matteoborghi/pecd-p7-kicad/PECD_P7.kicad_pcb

## KiCad design PECD_P7.kicad_pcb (2026-10-15)

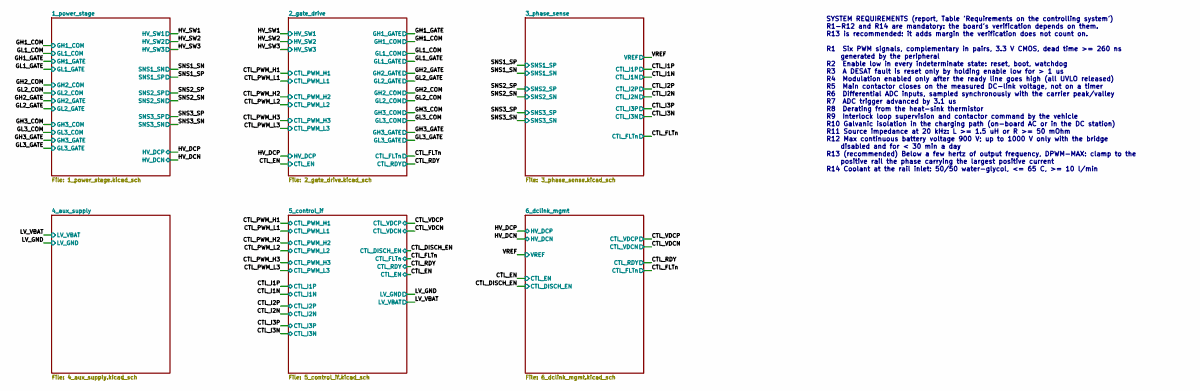
[picture p1: schematic PECD_P7.kicad_sch, Root sheet: blocks, interface and system requirements]

Notes on the sheet:
SYSTEM REQUIREMENTS (report, Table 'Requirements on the controlling system') R1-R12 and R14 are mandatory: the board's verification depends on them. R13 is recommended: it adds margin the verification does not count on. R1 Six PWM signals, complementary in pairs, 3.3 V CMOS, dead time >= 260 ns gen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

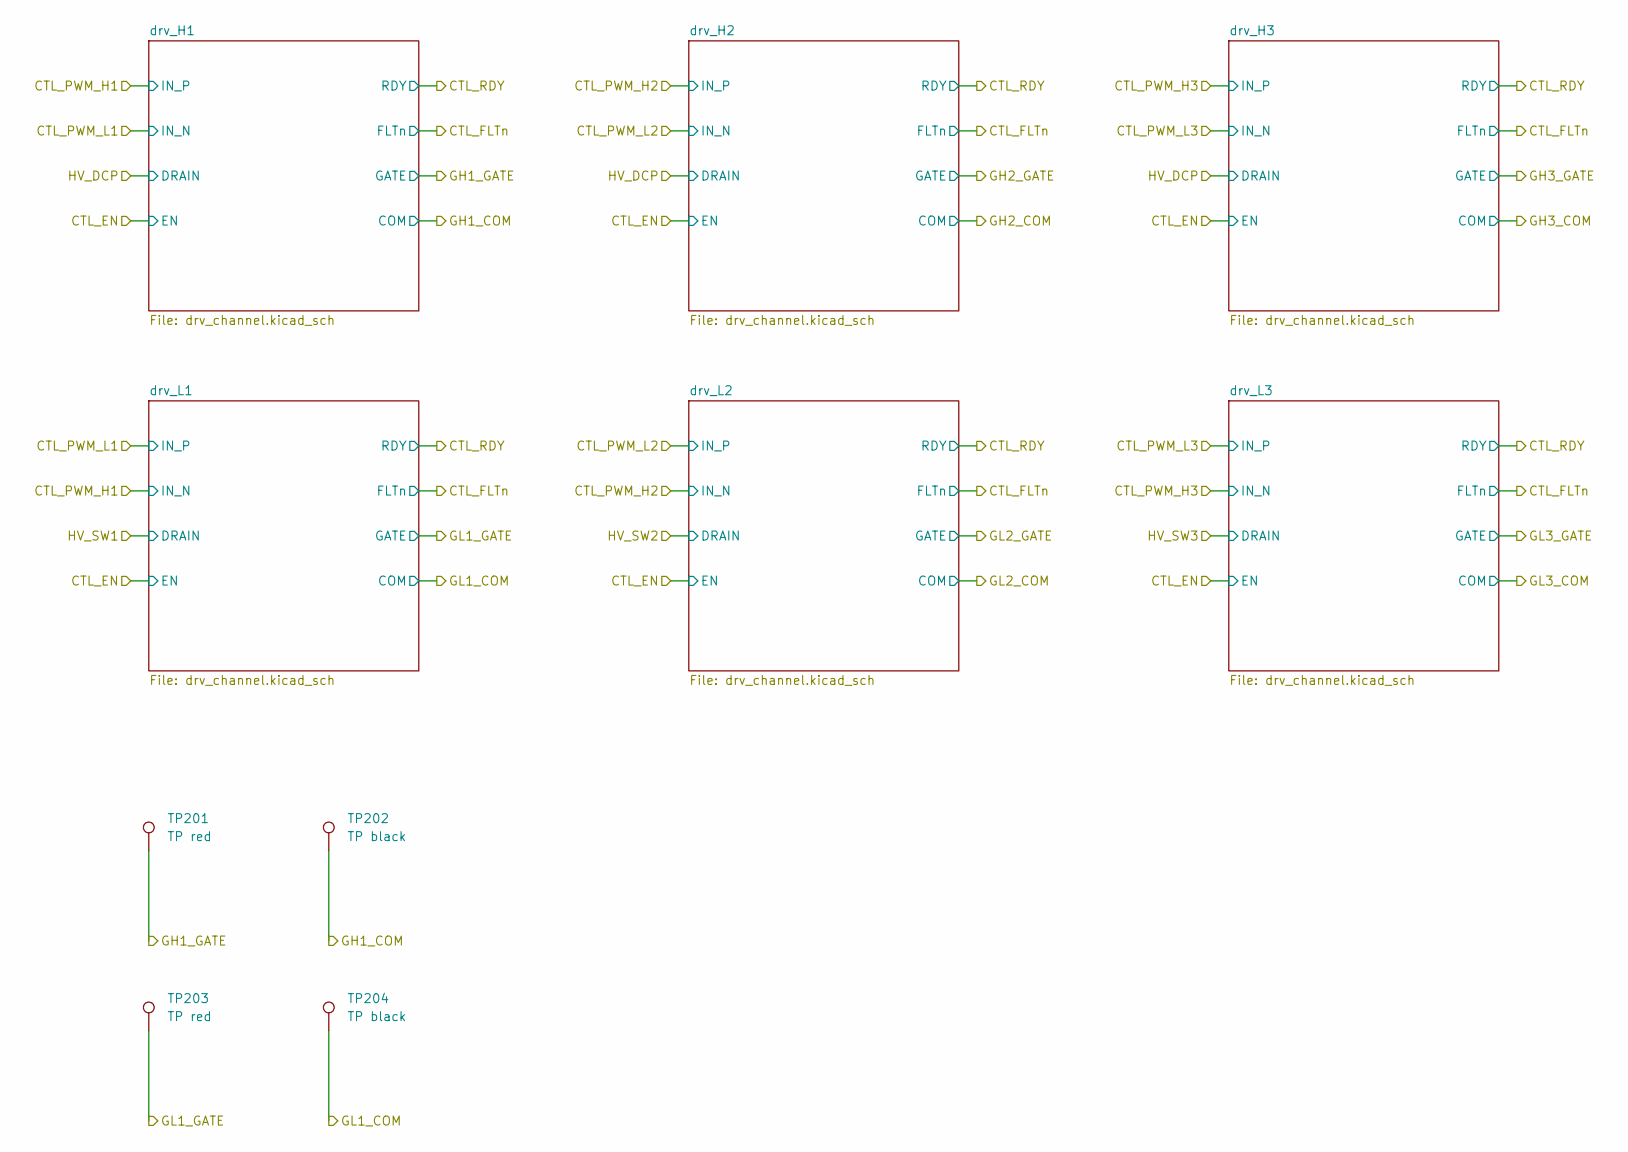
[picture p2: schematic 2_gate_drive.kicad_sch, Gate drive: seven channels and interlock]

Parts:
TP201, TP203: TP red; TestPoint_Keystone_5000-5004_Miniature; MPN 5000
TP202, TP204: TP black; TestPoint_Keystone_5000-5004_Miniature; MPN 5001

Connections:
/GH1_COM: TP202.1 (1_1); also elsewhere on the board
/GH1_GATE: TP201.1 (1_1); also elsewhere on the board
/GL1_COM: TP204.1 (1_1); also elsewhere on the board
/GL1_GATE: TP203.1 (1_1); also elsewhere on the board

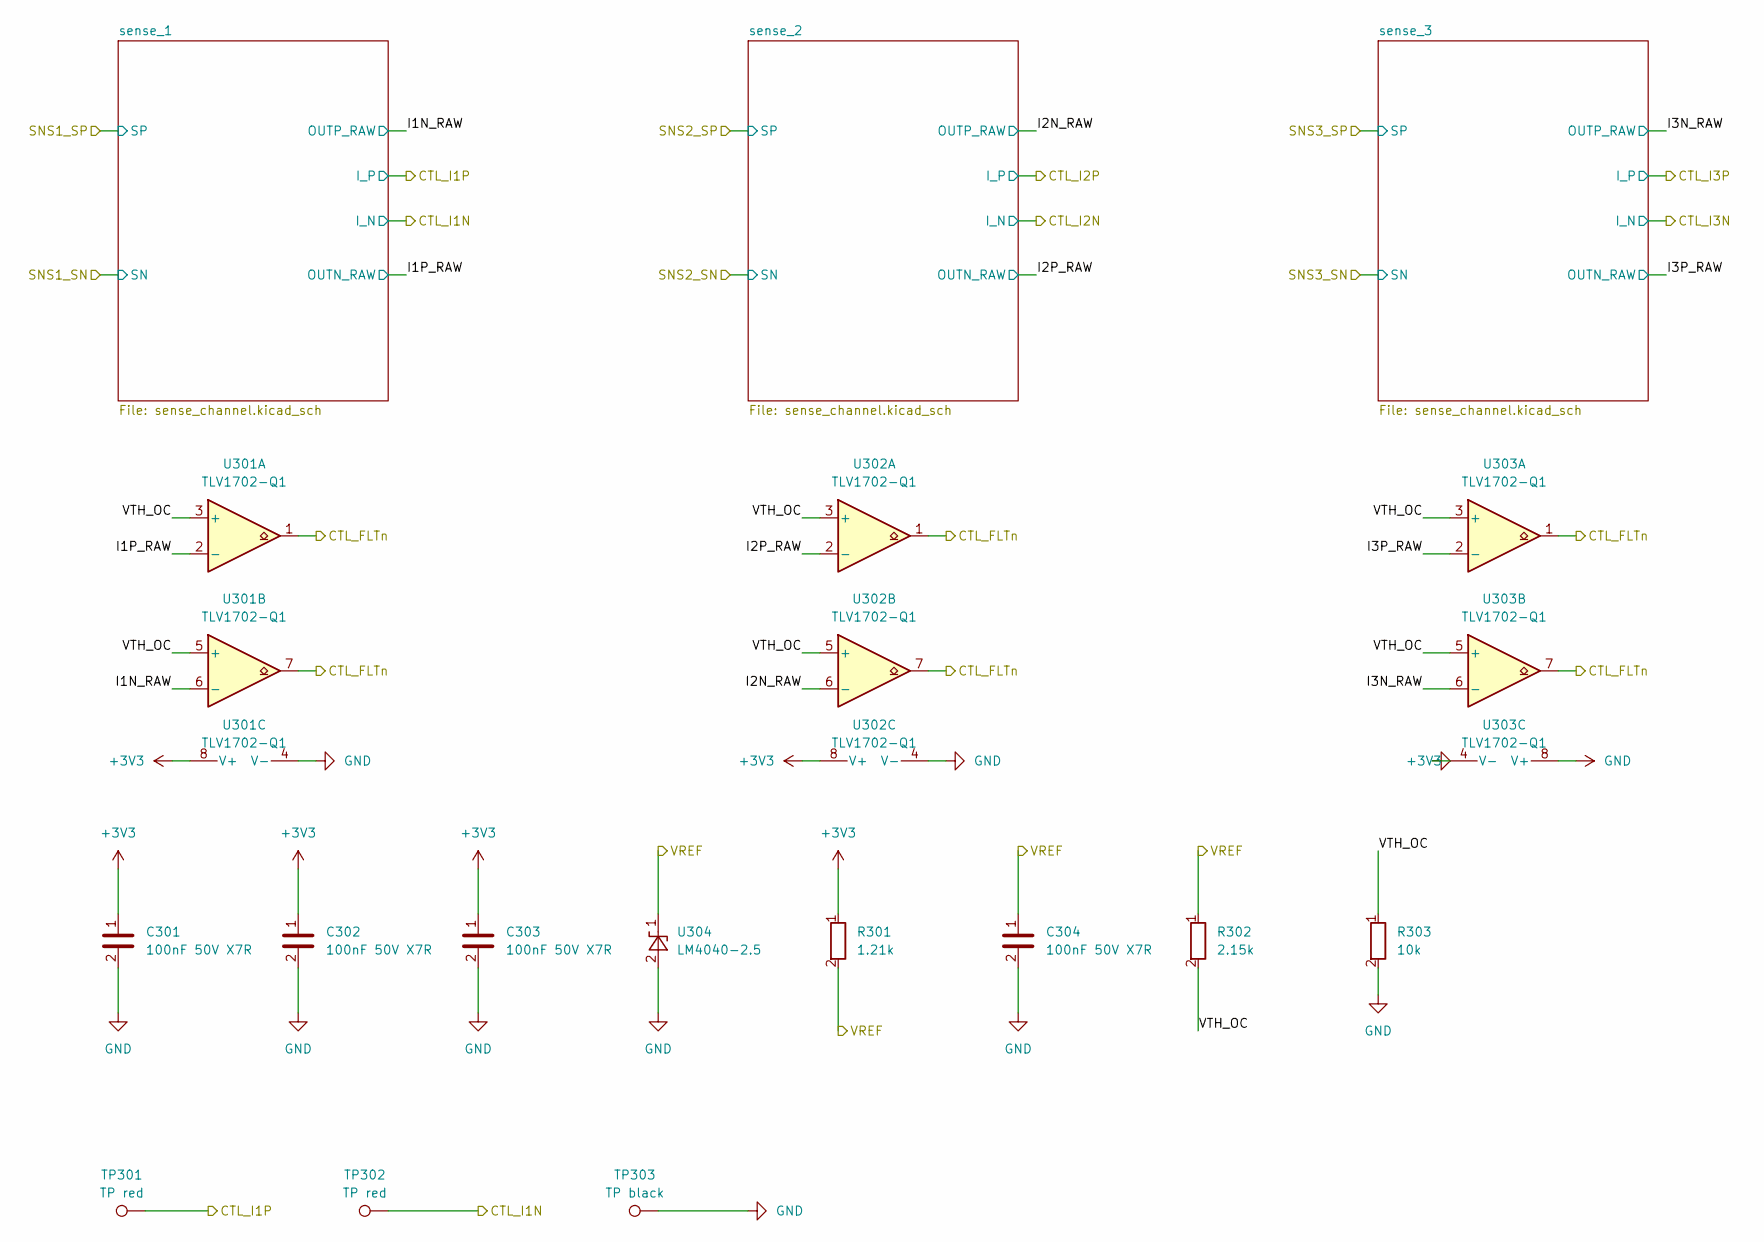
[picture p3: schematic 3_phase_sense.kicad_sch, Phase current sensing and overload comparators]

Parts:
C301, C302, C303, C304: 100nF 50V X7R; C_0603_1608Metric; MPN GCM188R71H104KA57D
R301: 1.21k; R_0603_1608Metric; MPN ERJ-3EKF1211V
R302: 2.15k; R_0603_1608Metric; MPN ERJ-3EKF2151V
R303: 10k; R_0603_1608Metric; MPN ERJ-3EKF1002V
TP301, TP302: TP red; TestPoint_Keystone_5000-5004_Miniature; MPN 5000
TP303: TP black; TestPoint_Keystone_5000-5004_Miniature; MPN 5001
U301, U302, U303: TLV1702-Q1; VSSOP-8_3x3mm_P0.65mm; MPN TLV1702AQDGKRQ1
U304: LM4040-2.5; SOT-23; MPN LM4040QBIM3-2.5/NOPB

Connections:
+3V3: C301.1, C302.1, C303.1, R301.1, U301.8 (V+), U302.8 (V+), U303.8 (V+); also elsewhere on the board
/3_phase_sense/I1N_RAW: U301.6 (-); also elsewhere on the board
/3_phase_sense/I1P_RAW: U301.2 (-); also elsewhere on the board
/3_phase_sense/I2N_RAW: U302.6 (-); also elsewhere on the board
/3_phase_sense/I2P_RAW: U302.2 (-); also elsewhere on the board
/3_phase_sense/I3N_RAW: U303.6 (-); also elsewhere on the board
/3_phase_sense/I3P_RAW: U303.2 (-); also elsewhere on the board
/3_phase_sense/VTH_OC: R302.2, R303.1, U301.3 (+), U301.5 (+), U302.3 (+), U302.5 (+), U303.3 (+), U303.5 (+)
/CTL_FLTn: U301.1, U301.7, U302.1, U302.7, U303.1, U303.7; also elsewhere on the board
/CTL_I1N: TP302.1 (1_1); also elsewhere on the board
/CTL_I1P: TP301.1 (1_1); also elsewhere on the board
/VREF: C304.1, R301.2, R302.1, U304.1 (K); also elsewhere on the board
GND: C301.2, C302.2, C303.2, C304.2, R303.2, TP303.1 (1_1), U301.4 (V-), U302.4 (V-), U303.4 (V-), U304.2 (A); also elsewhere on the board

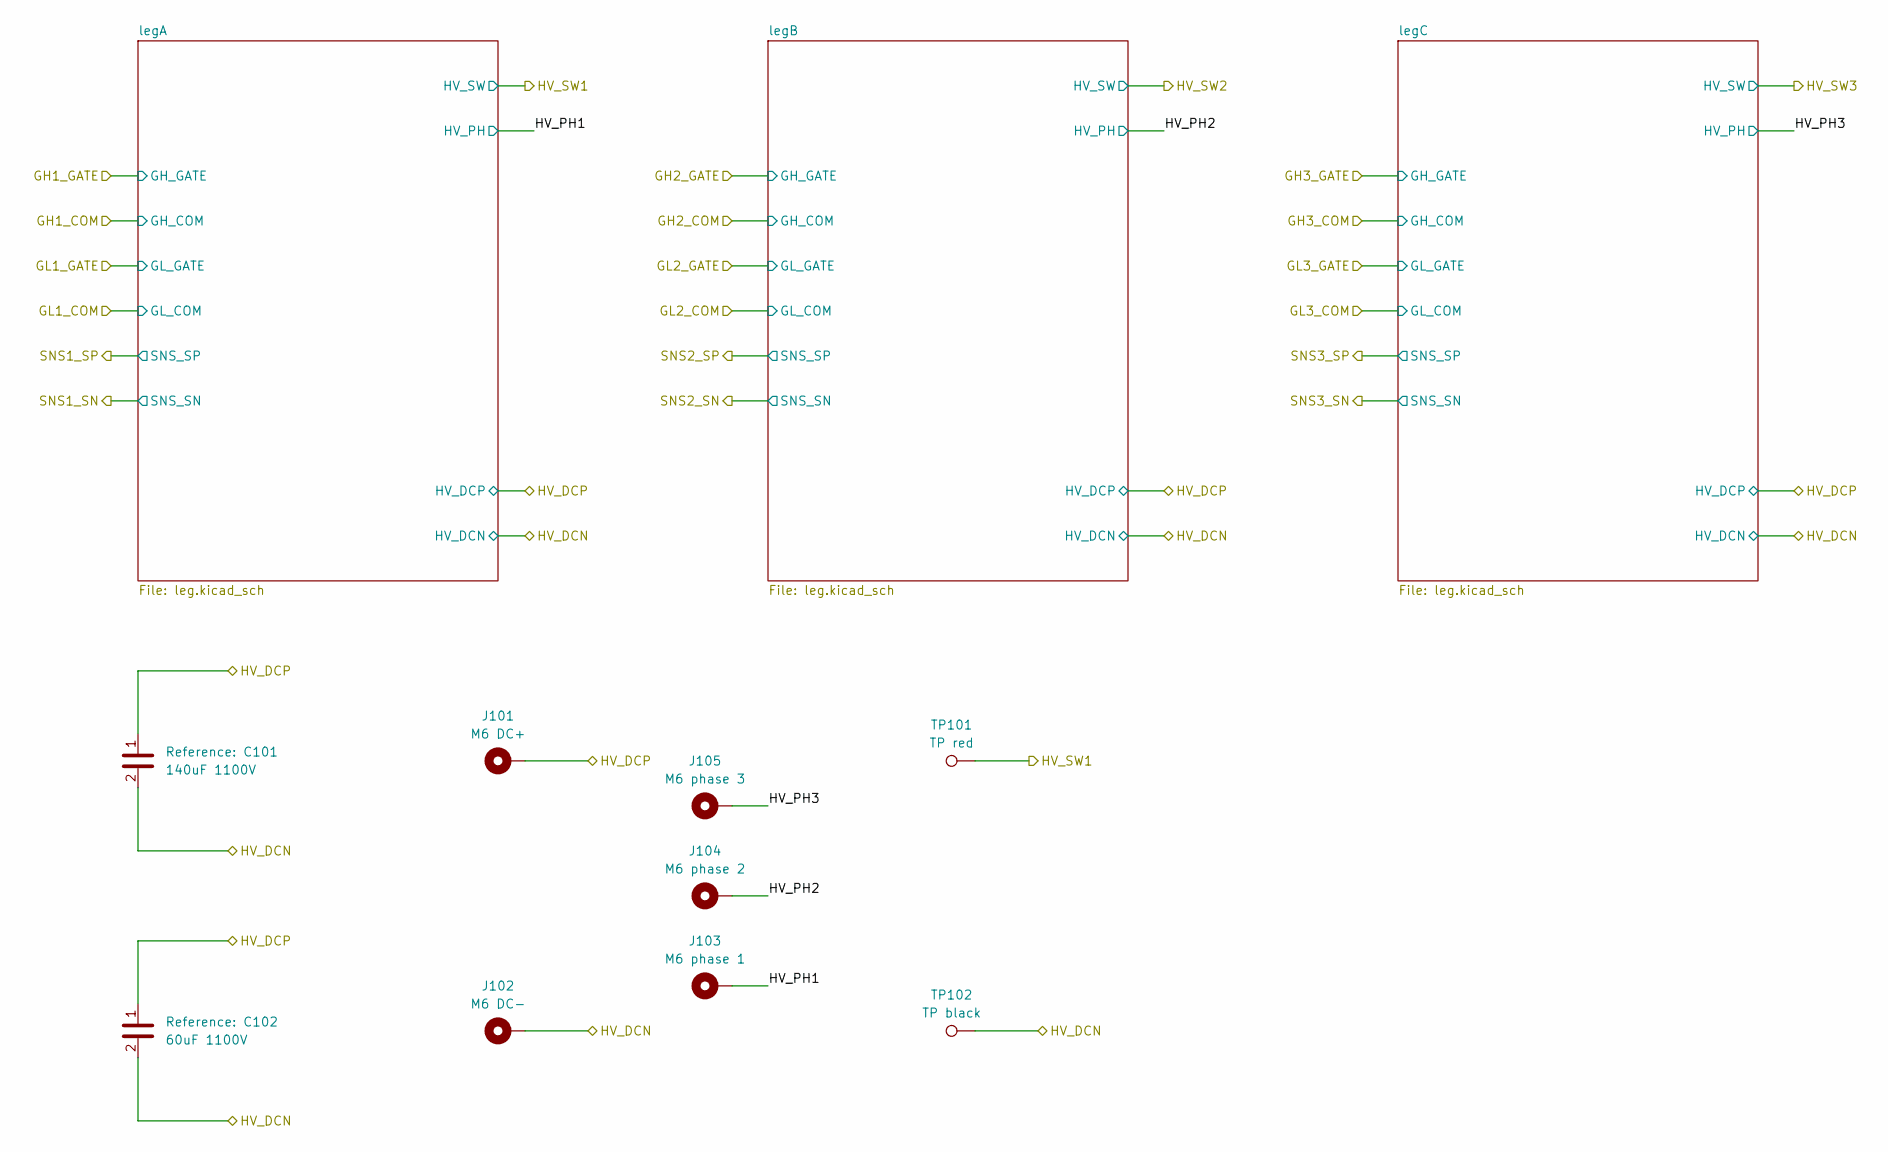
[picture p4: schematic 1_power_stage.kicad_sch, Power stage: DC-link and three legs]

Parts:
C101: 140uF 1100V; MKP1848_12pin_P52.5mm; MPN MKP1848714914Y5
C102: 60uF 1100V; MKP1848_6pin_P52.5mm; MPN MKP1848660914Y5
J101: M6 DC+; MountingHole_6.4mm_M6_Pad_Via
J102: M6 DC-; MountingHole_6.4mm_M6_Pad_Via
J103: M6 phase 1; MountingHole_6.4mm_M6_Pad_Via
J104: M6 phase 2; MountingHole_6.4mm_M6_Pad_Via
J105: M6 phase 3; MountingHole_6.4mm_M6_Pad_Via
TP101: TP red; TestPoint_Keystone_5000-5004_Miniature; MPN 5000
TP102: TP black; TestPoint_Keystone_5000-5004_Miniature; MPN 5001

Connections:
/1_power_stage/HV_PH1: J103.1 (1_1); also elsewhere on the board
/1_power_stage/HV_PH2: J104.1 (1_1); also elsewhere on the board
/1_power_stage/HV_PH3: J105.1 (1_1); also elsewhere on the board
/HV_DCN: C101.2, C102.2, J102.1 (1_1), TP102.1 (1_1); also elsewhere on the board
/HV_DCP: C101.1, C102.1, J101.1 (1_1); also elsewhere on the board
/HV_SW1: TP101.1 (1_1); also elsewhere on the board

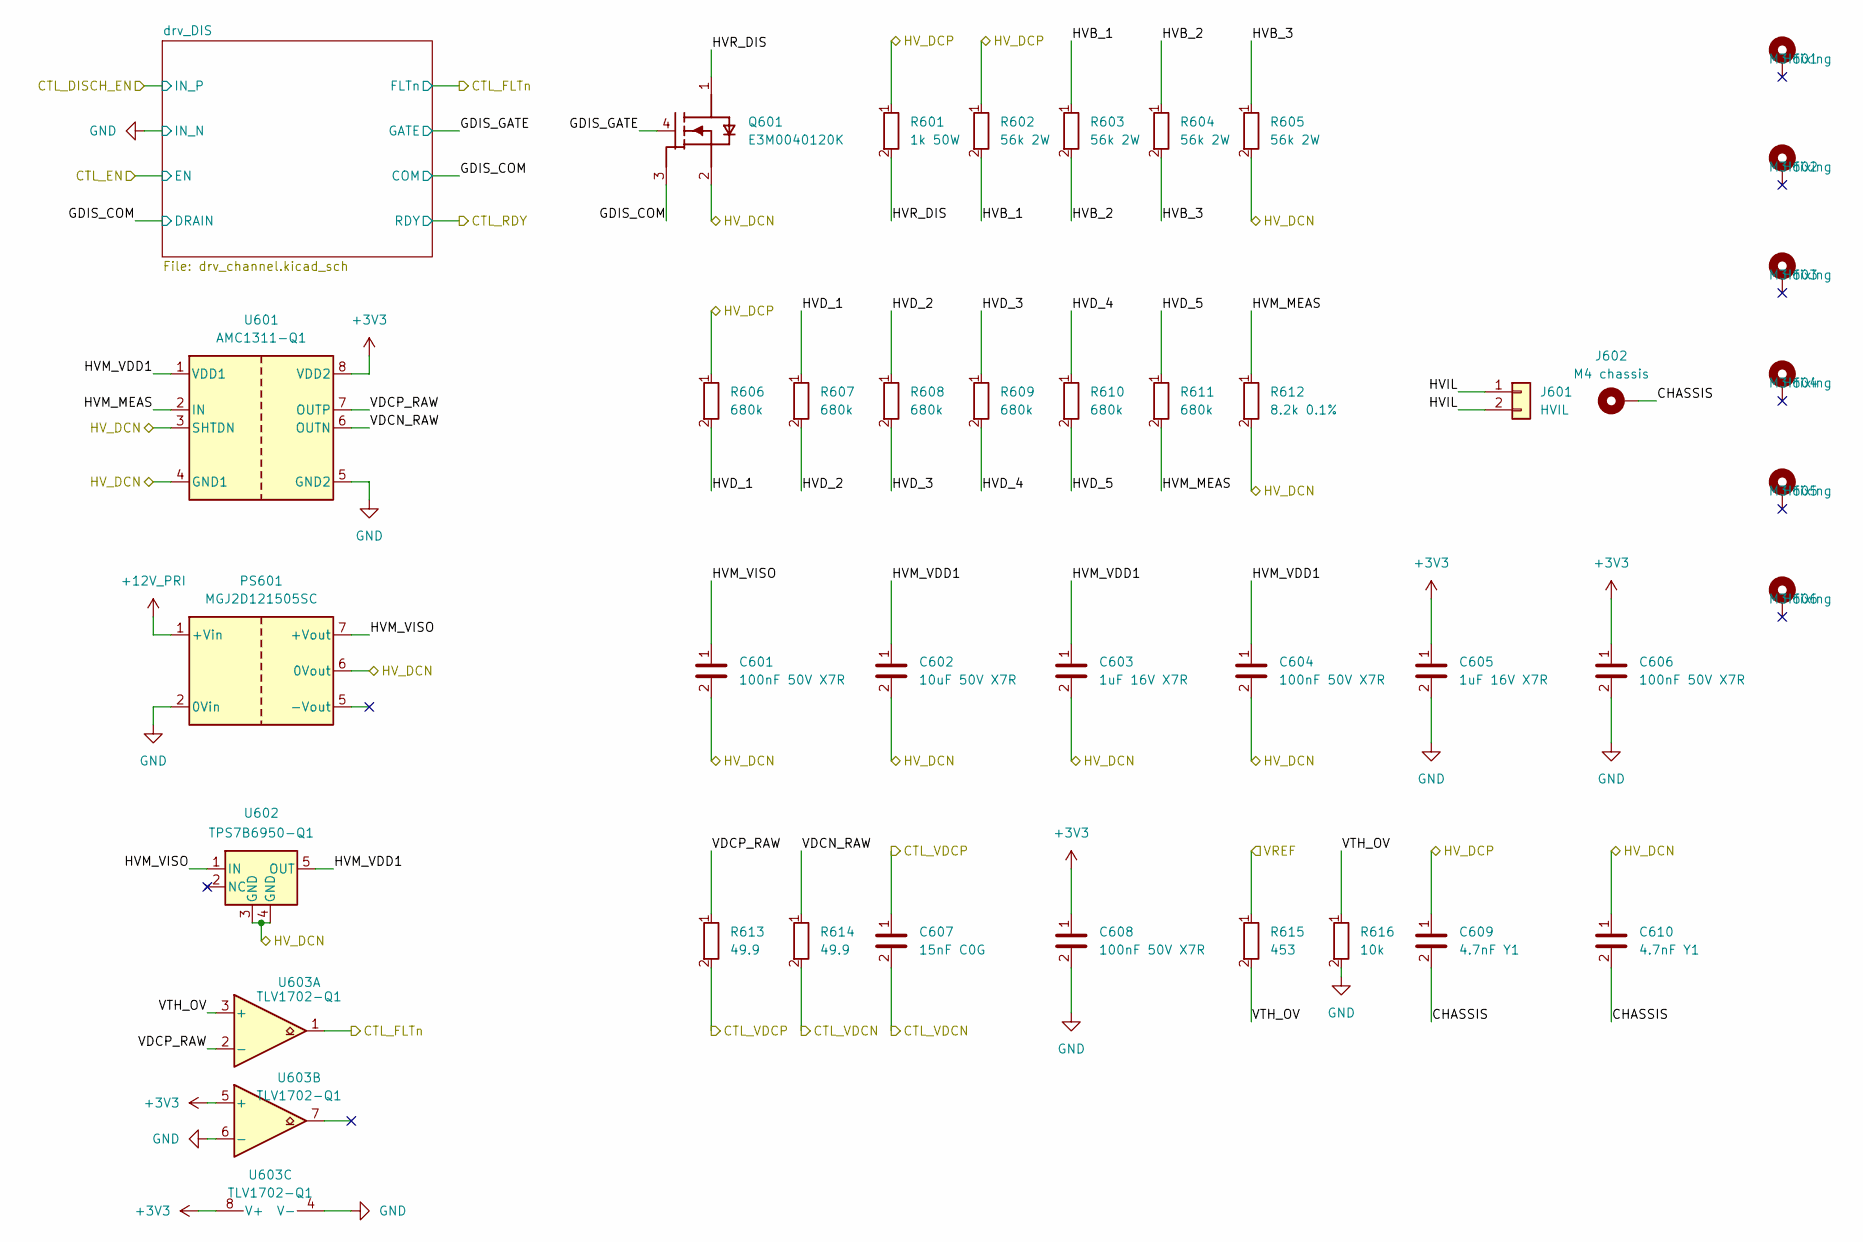
[picture p5: schematic 6_dclink_mgmt.kicad_sch, DC-link management: voltage sensing and active discharge]

Parts:
C601, C604, C606, C608: 100nF 50V X7R; C_0603_1608Metric; MPN GCM188R71H104KA57D
C602: 10uF 50V X7R; C_1210_3225Metric; MPN GRM32ER71H106KA12L
C603, C605: 1uF 16V X7R; C_0603_1608Metric; MPN GCM188R71C105KA64D
C607: 15nF C0G; C_0805_2012Metric; MPN GCM2195C1H153JA16D
C609, C610: 4.7nF Y1; C_Disc_Y1_D16.5_P12.5mm; MPN AY1472M65Y5UC63LX
H601, H602, H603, H604, H605, H606: M3 fixing; MountingHole_3.2mm_M3_Pad_Via
J601: HVIL; PhoenixContact_MSTBA_2,5_2-G-5,08_1x02_P5.08mm_Horizontal; MPN 1757242
J602: M4 chassis; MountingHole_4.3mm_M4_Pad_Via
PS601: MGJ2D121505SC; MGJ2_SIP7; MPN MGJ2D121505SC
Q601: E3M0040120K; TO-247-4L_Wolfspeed_Vertical; MPN E3M0040120K
R601: 1k 50W; Wire_HV_2x_P10mm; MPN HS50 1K J
R602, R603, R604, R605: 56k 2W; R_Axial_DIN0411_L9.9mm_D3.6mm_P15.24mm_Horizontal; MPN PR02000205602JR500
R606, R607, R608, R609, R610, R611: 680k; R_1206_3216Metric; MPN ERJ-8ENF6803V
R612: 8.2k 0.1%; R_1206_3216Metric; MPN ERA-3AEB822V
R613, R614: 49.9; R_0603_1608Metric; MPN ERJ-3EKF49R9V
R615: 453; R_0603_1608Metric; MPN ERJ-3EKF4530V
R616: 10k; R_0603_1608Metric; MPN ERJ-3EKF1002V
U601: AMC1311-Q1; SOIC-8W_TI_DWV_Slot; MPN AMC1311QDWVRQ1
U602: TPS7B6950-Q1; SOT-23-5; MPN TPS7B6950QDBVRQ1
U603: TLV1702-Q1; VSSOP-8_3x3mm_P0.65mm; MPN TLV1702AQDGKRQ1

Connections:
+3V3: C605.1, C606.1, C608.1, U601.8 (VDD2), U603.5 (+), U603.8 (V+); also elsewhere on the board
+12V_PRI: PS601.1 (+Vin); also elsewhere on the board
/6_dclink_mgmt/CHASSIS: C609.2, C610.2, J602.1 (1_1)
/6_dclink_mgmt/GDIS_COM: Q601.3 (S_K); also elsewhere on the board
/6_dclink_mgmt/GDIS_GATE: Q601.4 (G); also elsewhere on the board
/6_dclink_mgmt/HVB_1: R602.2, R603.1
/6_dclink_mgmt/HVB_2: R603.2, R604.1
/6_dclink_mgmt/HVB_3: R604.2, R605.1
/6_dclink_mgmt/HVD_1: R606.2, R607.1
/6_dclink_mgmt/HVD_2: R607.2, R608.1
/6_dclink_mgmt/HVD_3: R608.2, R609.1
/6_dclink_mgmt/HVD_4: R609.2, R610.1
/6_dclink_mgmt/HVD_5: R610.2, R611.1
/6_dclink_mgmt/HVIL: J601.1, J601.2
/6_dclink_mgmt/HVM_MEAS: R611.2, R612.1, U601.2 (IN)
/6_dclink_mgmt/HVM_VDD1: C602.1, C603.1, C604.1, U601.1 (VDD1), U602.5 (OUT)
/6_dclink_mgmt/HVM_VISO: C601.1, PS601.7 (+Vout), U602.1 (IN)
/6_dclink_mgmt/HVR_DIS: Q601.1 (D), R601.2
/6_dclink_mgmt/VDCN_RAW: R614.1, U601.6 (OUTN)
/6_dclink_mgmt/VDCP_RAW: R613.1, U601.7 (OUTP), U603.2 (-)
/6_dclink_mgmt/VTH_OV: R615.2, R616.1, U603.3 (+)
/CTL_FLTn: U603.1; also elsewhere on the board
/CTL_VDCN: C607.2, R614.2; also elsewhere on the board
/CTL_VDCP: C607.1, R613.2; also elsewhere on the board
/HV_DCN: C601.2, C602.2, C603.2, C604.2, C610.1, PS601.6 (0Vout), Q601.2 (S), R605.2, R612.2, U601.3 (SHTDN), U601.4 (GND1), U602.3 (GND), U602.4 (GND); also elsewhere on the board
/HV_DCP: C609.1, R601.1, R602.1, R606.1; also elsewhere on the board
/VREF: R615.1; also elsewhere on the board
GND: C605.2, C606.2, C608.2, PS601.2 (0Vin), R616.2, U601.5 (GND2), U603.4 (V-), U603.6 (-); also elsewhere on the board

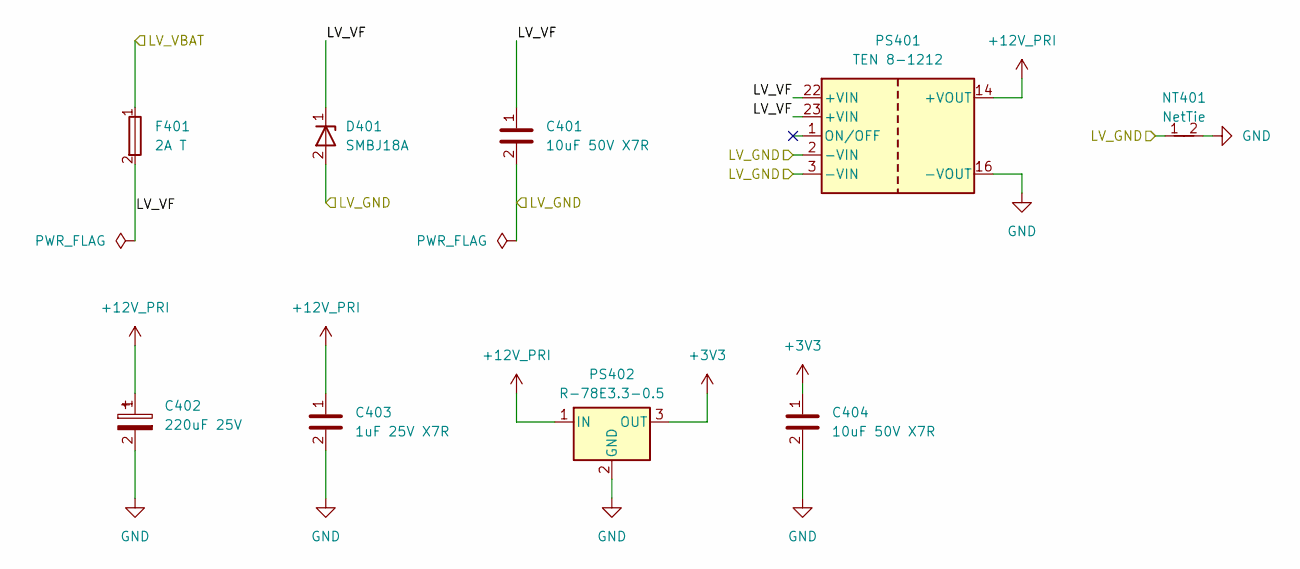
[picture p6: schematic 4_aux_supply.kicad_sch, Auxiliary supply: 12 V regulated and 3.3 V]

Parts:
C401, C404: 10uF 50V X7R; C_1210_3225Metric; MPN GRM32ER71H106KA12L
C402: 220uF 25V; CP_Elec_8x10.5; MPN EEE-FK1E221P
C403: 1uF 25V X7R; C_0603_1608Metric; MPN GCM188R71E105KA64D
D401: SMBJ18A; D_SMB; MPN SMBJ18A
F401: 2A T; Fuse_Littelfuse-NANO2-451_453; MPN 0452002.MRL
NT401: NetTie; NetTie-2_SMD_Pad0.5mm
PS401: TEN 8-1212; DIP-24_W15.24mm; MPN TEN 8-1212
PS402: R-78E3.3-0.5; Converter_DCDC_RECOM_R-78E-0.5_THT; MPN R-78E3.3-0.5

Connections:
+3V3: C404.1, PS402.3 (OUT); also elsewhere on the board
+12V_PRI: C402.1, C403.1, PS401.14 (+VOUT), PS402.1 (IN); also elsewhere on the board
/4_aux_supply/LV_VF: C401.1, D401.1 (K), F401.2, PS401.22 (+VIN), PS401.23 (+VIN)
/LV_GND: C401.2, D401.2 (A), NT401.1, PS401.2 (-VIN), PS401.3 (-VIN); also elsewhere on the board
/LV_VBAT: F401.1; also elsewhere on the board
GND: C402.2, C403.2, C404.2, NT401.2, PS401.16 (-VOUT), PS402.2 (GND); also elsewhere on the board

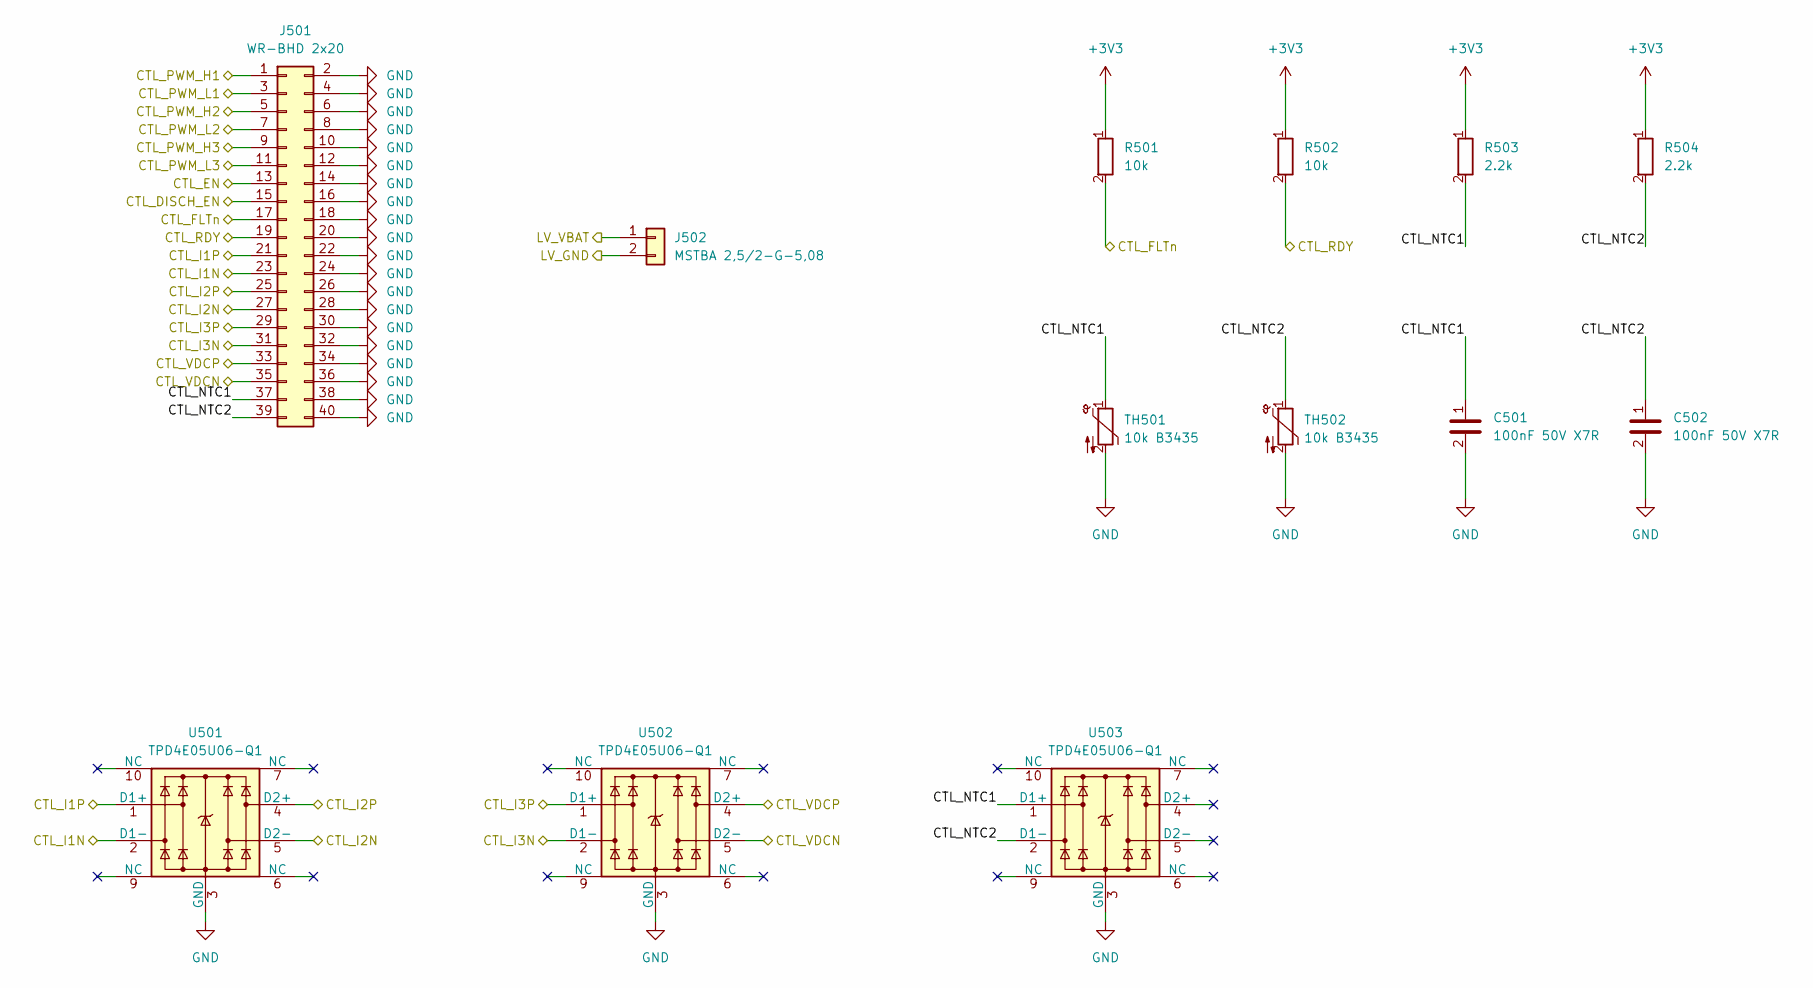
[picture p7: schematic 5_control_if.kicad_sch, Control interface: connector, filters, thermistors]

Parts:
C501, C502: 100nF 50V X7R; C_0603_1608Metric; MPN GCM188R71H104KA57D
J501: WR-BHD 2x20; IDC-Header_2x20_P2.54mm_Vertical; MPN 61204021621
J502: MSTBA 2,5/2-G-5,08; PhoenixContact_MSTBA_2,5_2-G-5,08_1x02_P5.08mm_Horizontal; MPN 1757242
R501, R502: 10k; R_0603_1608Metric; MPN ERJ-3EKF1002V
R503, R504: 2.2k; R_0603_1608Metric; MPN ERJ-3EKF2201V
TH501, TH502: 10k B3435; SolderWire-0.1sqmm_1x02_P3.6mm_D0.4mm_OD1mm; MPN NTCALUG01T103FL
U501, U502, U503: TPD4E05U06-Q1; USON-10_2.5x1.0mm_P0.5mm; MPN TPD4E05U06QDQARQ1

Connections:
+3V3: R501.1, R502.1, R503.1, R504.1; also elsewhere on the board
/5_control_if/CTL_NTC1: C501.1, J501.37, R503.2, TH501.1, U503.1 (D1+)
/5_control_if/CTL_NTC2: C502.1, J501.39, R504.2, TH502.1, U503.2 (D1-)
/CTL_DISCH_EN: J501.15; also elsewhere on the board
/CTL_EN: J501.13; also elsewhere on the board
/CTL_FLTn: J501.17, R501.2; also elsewhere on the board
/CTL_I1N: J501.23, U501.2 (D1-); also elsewhere on the board
/CTL_I1P: J501.21, U501.1 (D1+); also elsewhere on the board
/CTL_I2N: J501.27, U501.5 (D2-); also elsewhere on the board
/CTL_I2P: J501.25, U501.4 (D2+); also elsewhere on the board
/CTL_I3N: J501.31, U502.2 (D1-); also elsewhere on the board
/CTL_I3P: J501.29, U502.1 (D1+); also elsewhere on the board
/CTL_PWM_H1: J501.1; also elsewhere on the board
/CTL_PWM_H2: J501.5; also elsewhere on the board
/CTL_PWM_H3: J501.9; also elsewhere on the board
/CTL_PWM_L1: J501.3; also elsewhere on the board
/CTL_PWM_L2: J501.7; also elsewhere on the board
/CTL_PWM_L3: J501.11; also elsewhere on the board
/CTL_RDY: J501.19, R502.2; also elsewhere on the board
/CTL_VDCN: J501.35, U502.5 (D2-); also elsewhere on the board
/CTL_VDCP: J501.33, U502.4 (D2+); also elsewhere on the board
/LV_GND: J502.2; also elsewhere on the board
/LV_VBAT: J502.1; also elsewhere on the board
GND: C501.2, C502.2, J501.2, J501.4, J501.6, J501.8, J501.10, J501.12, J501.14, J501.16, J501.18, J501.20, J501.22, J501.24, J501.26, J501.28, J501.30, J501.32, J501.34, J501.36, J501.38, J501.40, TH501.2, TH502.2, U501.3 (GND), U501.8 (GND), U502.3 (GND), U502.8 (GND), U503.3 (GND), U503.8 (GND); also elsewhere on the board
