matteoborghi/pecd-p7-kicad/PECD_P7.kicad_pcb

## KiCad design PECD_P7.kicad_pcb (continued)

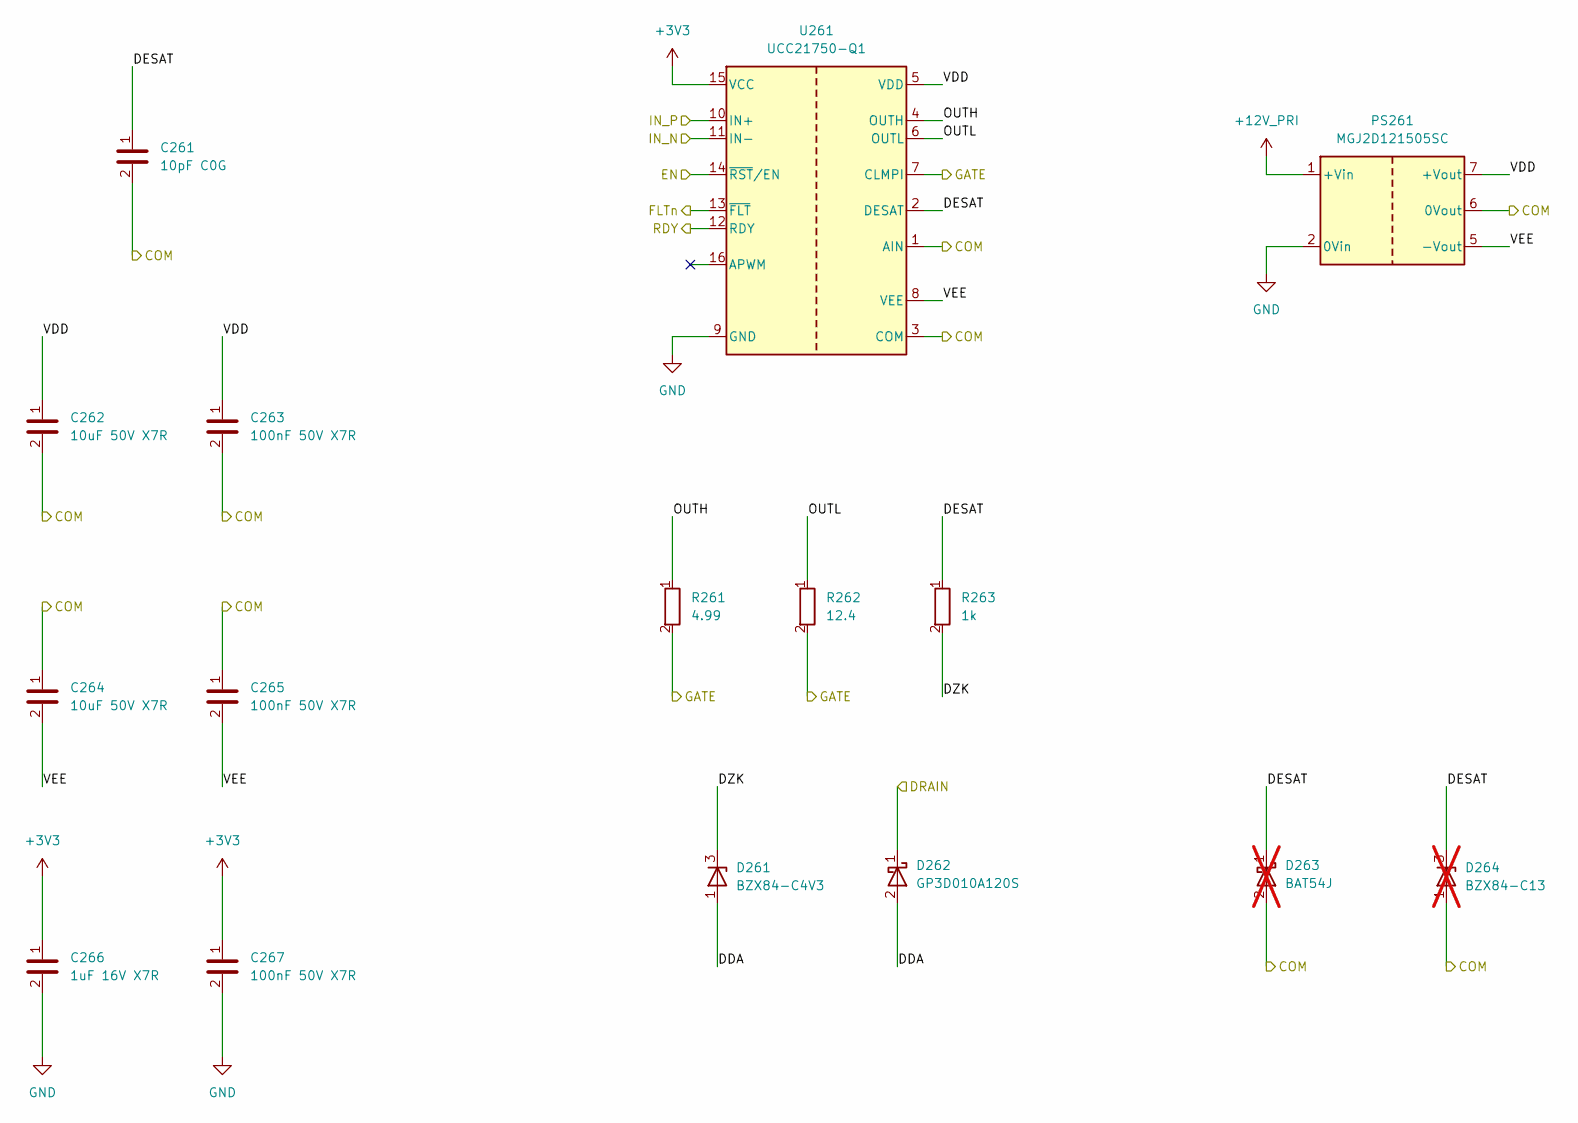
[picture p8: schematic drv_channel.kicad_sch, Gate-drive channel (7 instances)]

Parts:
C261: 10pF C0G; C_0603_1608Metric; MPN GCM1885C1H100JA16D
C262, C264: 10uF 50V X7R; C_1210_3225Metric; MPN GRM32ER71H106KA12L
C263, C265, C267: 100nF 50V X7R; C_0603_1608Metric; MPN GCM188R71H104KA57D
C266: 1uF 16V X7R; C_0603_1608Metric; MPN GCM188R71C105KA64D
D261: BZX84-C4V3; SOT-23; MPN BZX84-C4V3,215
D262: GP3D010A120S; D_SMC_HV; MPN GP3D010A120S
D263: BAT54J; D_SOD-323F; MPN BAT54J,115; not fitted
D264: BZX84-C13; SOT-23; MPN BZX84-C13,215; not fitted
PS261: MGJ2D121505SC; MGJ2_SIP7; MPN MGJ2D121505SC
R261: 4.99; R_1206_3216Metric; MPN CRCW12064R99FKEAHP
R262: 12.4; R_1206_3216Metric; MPN ERJ-P08F12R4V
R263: 1k; R_0603_1608Metric; MPN ERJ-3EKF1001V
U261: UCC21750-Q1; SOIC-16W_TI_DW_HV_Slot; MPN UCC21750QDWRQ1

Connections:
+3V3: C266.1, C267.1, U261.15 (VCC); also elsewhere on the board
+12V_PRI: PS261.1 (+Vin); also elsewhere on the board
/2_gate_drive/drv_L3/DDA: D261.1 (A), D262.2 (A)
/2_gate_drive/drv_L3/DESAT: C261.1, D263.1 (K), D264.3 (K), R263.1, U261.2 (DESAT)
/2_gate_drive/drv_L3/DZK: D261.3 (K), R263.2
/2_gate_drive/drv_L3/OUTH: R261.1, U261.4 (OUTH)
/2_gate_drive/drv_L3/OUTL: R262.1, U261.6 (OUTL)
/2_gate_drive/drv_L3/VDD: C262.1, C263.1, PS261.7 (+Vout), U261.5 (VDD)
/2_gate_drive/drv_L3/VEE: C264.2, C265.2, PS261.5 (-Vout), U261.8 (VEE)
/CTL_EN: U261.14 (~RST/EN); also elsewhere on the board
/CTL_FLTn: U261.13 (~FLT); also elsewhere on the board
/CTL_PWM_H3: U261.11 (IN-); also elsewhere on the board
/CTL_PWM_L3: U261.10 (IN+); also elsewhere on the board
/CTL_RDY: U261.12 (RDY); also elsewhere on the board
/GL3_COM: C261.2, C262.2, C263.2, C264.1, C265.1, D263.2 (A), D264.1 (A), PS261.6 (0Vout), U261.1 (AIN), U261.3 (COM); also elsewhere on the board
/GL3_GATE: R261.2, R262.2, U261.7 (CLMPI); also elsewhere on the board
/HV_SW3: D262.1 (K); also elsewhere on the board
GND: C266.2, C267.2, PS261.2 (0Vin), U261.9 (GND); also elsewhere on the board

Parts of its further copies:
C211, C221, C231, C241, C251, C681: 10pF C0G; C_0603_1608Metric; MPN GCM1885C1H100JA16D
C212, C214, C222, C224, C232, C234, C242, C244, C252, C254, C682, C684: 10uF 50V X7R; C_1210_3225Metric; MPN GRM32ER71H106KA12L
C213, C215, C217, C223, C225, C227, C233, C235, C237, C243, C245, C247, C253, C255, C257, C683, C685, C687: 100nF 50V X7R; C_0603_1608Metric; MPN GCM188R71H104KA57D
C216, C226, C236, C246, C256, C686: 1uF 16V X7R; C_0603_1608Metric; MPN GCM188R71C105KA64D
D211, D221, D231, D241, D251, D681: BZX84-C4V3; SOT-23; MPN BZX84-C4V3,215
D212, D222, D232, D242, D252, D682: GP3D010A120S; D_SMC_HV; MPN GP3D010A120S
D213, D223, D233, D243, D253, D683: BAT54J; D_SOD-323F; MPN BAT54J,115; not fitted
D214, D224, D234, D244, D254, D684: BZX84-C13; SOT-23; MPN BZX84-C13,215; not fitted
PS211, PS221, PS231, PS241, PS251, PS681: MGJ2D121505SC; MGJ2_SIP7; MPN MGJ2D121505SC
R211, R221, R231, R241, R251, R681: 4.99; R_1206_3216Metric; MPN CRCW12064R99FKEAHP
R212, R222, R232, R242, R252, R682: 12.4; R_1206_3216Metric; MPN ERJ-P08F12R4V
R213, R223, R233, R243, R253, R683: 1k; R_0603_1608Metric; MPN ERJ-3EKF1001V
U211, U221, U231, U241, U251, U681: UCC21750-Q1; SOIC-16W_TI_DW_HV_Slot; MPN UCC21750QDWRQ1

Connections of its further copies:
+3V3: C216.1, C217.1, C226.1, C227.1, C236.1, C237.1, C246.1, C247.1, C256.1, C257.1, C686.1, C687.1, U211.15 (VCC), U221.15 (VCC), U231.15 (VCC), U241.15 (VCC), U251.15 (VCC), U681.15 (VCC); also elsewhere on the board
+12V_PRI: PS211.1 (+Vin), PS221.1 (+Vin), PS231.1 (+Vin), PS241.1 (+Vin), PS251.1 (+Vin), PS681.1 (+Vin); also elsewhere on the board
/2_gate_drive/drv_H1/DDA: D211.1 (A), D212.2 (A)
/2_gate_drive/drv_H1/DESAT: C211.1, D213.1 (K), D214.3 (K), R213.1, U211.2 (DESAT)
/2_gate_drive/drv_H1/DZK: D211.3 (K), R213.2
/2_gate_drive/drv_H1/OUTH: R211.1, U211.4 (OUTH)
/2_gate_drive/drv_H1/OUTL: R212.1, U211.6 (OUTL)
/2_gate_drive/drv_H1/VDD: C212.1, C213.1, PS211.7 (+Vout), U211.5 (VDD)
/2_gate_drive/drv_H1/VEE: C214.2, C215.2, PS211.5 (-Vout), U211.8 (VEE)
/2_gate_drive/drv_H2/DDA: D231.1 (A), D232.2 (A)
/2_gate_drive/drv_H2/DESAT: C231.1, D233.1 (K), D234.3 (K), R233.1, U231.2 (DESAT)
/2_gate_drive/drv_H2/DZK: D231.3 (K), R233.2
/2_gate_drive/drv_H2/OUTH: R231.1, U231.4 (OUTH)
/2_gate_drive/drv_H2/OUTL: R232.1, U231.6 (OUTL)
/2_gate_drive/drv_H2/VDD: C232.1, C233.1, PS231.7 (+Vout), U231.5 (VDD)
/2_gate_drive/drv_H2/VEE: C234.2, C235.2, PS231.5 (-Vout), U231.8 (VEE)
/2_gate_drive/drv_H3/DDA: D251.1 (A), D252.2 (A)
/2_gate_drive/drv_H3/DESAT: C251.1, D253.1 (K), D254.3 (K), R253.1, U251.2 (DESAT)
/2_gate_drive/drv_H3/DZK: D251.3 (K), R253.2
/2_gate_drive/drv_H3/OUTH: R251.1, U251.4 (OUTH)
/2_gate_drive/drv_H3/OUTL: R252.1, U251.6 (OUTL)
/2_gate_drive/drv_H3/VDD: C252.1, C253.1, PS251.7 (+Vout), U251.5 (VDD)
/2_gate_drive/drv_H3/VEE: C254.2, C255.2, PS251.5 (-Vout), U251.8 (VEE)
/2_gate_drive/drv_L1/DDA: D221.1 (A), D222.2 (A)
/2_gate_drive/drv_L1/DESAT: C221.1, D223.1 (K), D224.3 (K), R223.1, U221.2 (DESAT)
/2_gate_drive/drv_L1/DZK: D221.3 (K), R223.2
/2_gate_drive/drv_L1/OUTH: R221.1, U221.4 (OUTH)
/2_gate_drive/drv_L1/OUTL: R222.1, U221.6 (OUTL)
/2_gate_drive/drv_L1/VDD: C222.1, C223.1, PS221.7 (+Vout), U221.5 (VDD)
/2_gate_drive/drv_L1/VEE: C224.2, C225.2, PS221.5 (-Vout), U221.8 (VEE)
/2_gate_drive/drv_L2/DDA: D241.1 (A), D242.2 (A)
/2_gate_drive/drv_L2/DESAT: C241.1, D243.1 (K), D244.3 (K), R243.1, U241.2 (DESAT)
/2_gate_drive/drv_L2/DZK: D241.3 (K), R243.2
/2_gate_drive/drv_L2/OUTH: R241.1, U241.4 (OUTH)
/2_gate_drive/drv_L2/OUTL: R242.1, U241.6 (OUTL)
/2_gate_drive/drv_L2/VDD: C242.1, C243.1, PS241.7 (+Vout), U241.5 (VDD)
/2_gate_drive/drv_L2/VEE: C244.2, C245.2, PS241.5 (-Vout), U241.8 (VEE)
/6_dclink_mgmt/GDIS_COM: C681.2, C682.2, C683.2, C684.1, C685.1, D682.1 (K), D683.2 (A), D684.1 (A), PS681.6 (0Vout), U681.1 (AIN), U681.3 (COM); also elsewhere on the board
/6_dclink_mgmt/GDIS_GATE: R681.2, R682.2, U681.7 (CLMPI); also elsewhere on the board
/6_dclink_mgmt/drv_DIS/DDA: D681.1 (A), D682.2 (A)
/6_dclink_mgmt/drv_DIS/DESAT: C681.1, D683.1 (K), D684.3 (K), R683.1, U681.2 (DESAT)
/6_dclink_mgmt/drv_DIS/DZK: D681.3 (K), R683.2
/6_dclink_mgmt/drv_DIS/OUTH: R681.1, U681.4 (OUTH)
/6_dclink_mgmt/drv_DIS/OUTL: R682.1, U681.6 (OUTL)
/6_dclink_mgmt/drv_DIS/VDD: C682.1, C683.1, PS681.7 (+Vout), U681.5 (VDD)
/6_dclink_mgmt/drv_DIS/VEE: C684.2, C685.2, PS681.5 (-Vout), U681.8 (VEE)
/CTL_DISCH_EN: U681.10 (IN+); also elsewhere on the board
/CTL_EN: U211.14 (~RST/EN), U221.14 (~RST/EN), U231.14 (~RST/EN), U241.14 (~RST/EN), U251.14 (~RST/EN), U681.14 (~RST/EN); also elsewhere on the board
/CTL_FLTn: U211.13 (~FLT), U221.13 (~FLT), U231.13 (~FLT), U241.13 (~FLT), U251.13 (~FLT), U681.13 (~FLT); also elsewhere on the board
/CTL_PWM_H1: U211.10 (IN+), U221.11 (IN-); also elsewhere on the board
/CTL_PWM_H2: U231.10 (IN+), U241.11 (IN-); also elsewhere on the board
/CTL_PWM_H3: U251.10 (IN+); also elsewhere on the board
/CTL_PWM_L1: U211.11 (IN-), U221.10 (IN+); also elsewhere on the board
/CTL_PWM_L2: U231.11 (IN-), U241.10 (IN+); also elsewhere on the board
/CTL_PWM_L3: U251.11 (IN-); also elsewhere on the board
/CTL_RDY: U211.12 (RDY), U221.12 (RDY), U231.12 (RDY), U241.12 (RDY), U251.12 (RDY), U681.12 (RDY); also elsewhere on the board
/GH1_COM: C211.2, C212.2, C213.2, C214.1, C215.1, D213.2 (A), D214.1 (A), PS211.6 (0Vout), U211.1 (AIN), U211.3 (COM); also elsewhere on the board
/GH1_GATE: R211.2, R212.2, U211.7 (CLMPI); also elsewhere on the board
/GH2_COM: C231.2, C232.2, C233.2, C234.1, C235.1, D233.2 (A), D234.1 (A), PS231.6 (0Vout), U231.1 (AIN), U231.3 (COM); also elsewhere on the board
/GH2_GATE: R231.2, R232.2, U231.7 (CLMPI); also elsewhere on the board
/GH3_COM: C251.2, C252.2, C253.2, C254.1, C255.1, D253.2 (A), D254.1 (A), PS251.6 (0Vout), U251.1 (AIN), U251.3 (COM); also elsewhere on the board
/GH3_GATE: R251.2, R252.2, U251.7 (CLMPI); also elsewhere on the board
/GL1_COM: C221.2, C222.2, C223.2, C224.1, C225.1, D223.2 (A), D224.1 (A), PS221.6 (0Vout), U221.1 (AIN), U221.3 (COM); also elsewhere on the board
/GL1_GATE: R221.2, R222.2, U221.7 (CLMPI); also elsewhere on the board
/GL2_COM: C241.2, C242.2, C243.2, C244.1, C245.1, D243.2 (A), D244.1 (A), PS241.6 (0Vout), U241.1 (AIN), U241.3 (COM); also elsewhere on the board
/GL2_GATE: R241.2, R242.2, U241.7 (CLMPI); also elsewhere on the board
/HV_DCP: D212.1 (K), D232.1 (K), D252.1 (K); also elsewhere on the board
/HV_SW1: D222.1 (K); also elsewhere on the board
/HV_SW2: D242.1 (K); also elsewhere on the board
GND: C216.2, C217.2, C226.2, C227.2, C236.2, C237.2, C246.2, C247.2, C256.2, C257.2, C686.2, C687.2, PS211.2 (0Vin), PS221.2 (0Vin), PS231.2 (0Vin), PS241.2 (0Vin), PS251.2 (0Vin), PS681.2 (0Vin), U211.9 (GND), U221.9 (GND), U231.9 (GND), U241.9 (GND), U251.9 (GND), U681.9 (GND), U681.11 (IN-); also elsewhere on the board

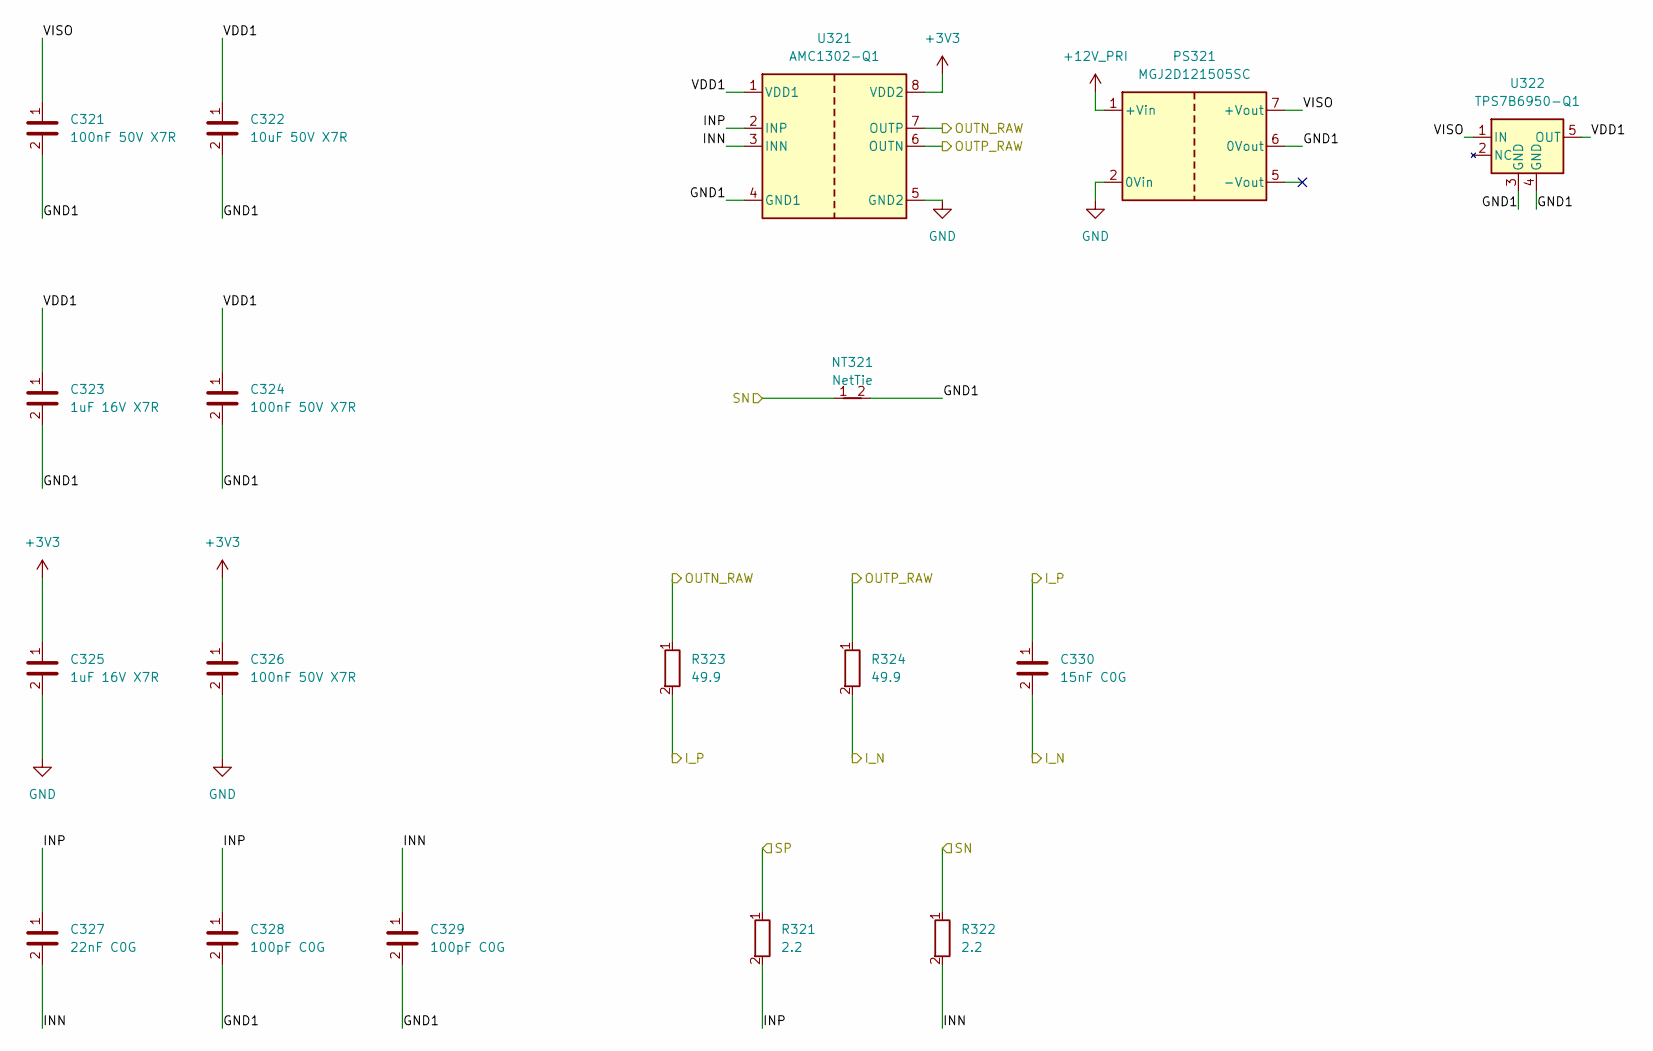
[picture p9: schematic sense_channel.kicad_sch, Phase current sensing channel (3 instances)]

Parts:
C321, C324, C326: 100nF 50V X7R; C_0603_1608Metric; MPN GCM188R71H104KA57D
C322: 10uF 50V X7R; C_1210_3225Metric; MPN GRM32ER71H106KA12L
C323, C325: 1uF 16V X7R; C_0603_1608Metric; MPN GCM188R71C105KA64D
C327: 22nF C0G; C_0805_2012Metric; MPN GCM21B5C1H223JA16L
C328, C329: 100pF C0G; C_0603_1608Metric; MPN GCM1885C1H101JA16D
C330: 15nF C0G; C_0805_2012Metric; MPN GCM2195C1H153JA16D
NT321: NetTie; NetTie-2_SMD_Pad0.5mm
PS321: MGJ2D121505SC; MGJ2_SIP7; MPN MGJ2D121505SC
R321, R322: 2.2; R_0603_1608Metric; MPN ERJ-3RQF2R2V
R323, R324: 49.9; R_0603_1608Metric; MPN ERJ-3EKF49R9V
U321: AMC1302-Q1; SOIC-8W_TI_DWV_Slot; MPN AMC1302QDWVRQ1
U322: TPS7B6950-Q1; SOT-23-5; MPN TPS7B6950QDBVRQ1

Connections:
+3V3: C325.1, C326.1, U321.8 (VDD2); also elsewhere on the board
+12V_PRI: PS321.1 (+Vin); also elsewhere on the board
/3_phase_sense/I1N_RAW: R324.1, U321.6 (OUTN); also elsewhere on the board
/3_phase_sense/I1P_RAW: R323.1, U321.7 (OUTP); also elsewhere on the board
/3_phase_sense/sense_1/GND1: C321.2, C322.2, C323.2, C324.2, C328.2, C329.2, NT321.2, PS321.6 (0Vout), U321.4 (GND1), U322.3 (GND), U322.4 (GND)
/3_phase_sense/sense_1/INN: C327.2, C329.1, R322.2, U321.3 (INN)
/3_phase_sense/sense_1/INP: C327.1, C328.1, R321.2, U321.2 (INP)
/3_phase_sense/sense_1/VDD1: C322.1, C323.1, C324.1, U321.1 (VDD1), U322.5 (OUT)
/3_phase_sense/sense_1/VISO: C321.1, PS321.7 (+Vout), U322.1 (IN)
/CTL_I1N: C330.2, R324.2; also elsewhere on the board
/CTL_I1P: C330.1, R323.2; also elsewhere on the board
/SNS1_SN: NT321.1, R322.1; also elsewhere on the board
/SNS1_SP: R321.1; also elsewhere on the board
GND: C325.2, C326.2, PS321.2 (0Vin), U321.5 (GND2); also elsewhere on the board

Parts of its further copies:
C341, C344, C346, C361, C364, C366: 100nF 50V X7R; C_0603_1608Metric; MPN GCM188R71H104KA57D
C342, C362: 10uF 50V X7R; C_1210_3225Metric; MPN GRM32ER71H106KA12L
C343, C345, C363, C365: 1uF 16V X7R; C_0603_1608Metric; MPN GCM188R71C105KA64D
C347, C367: 22nF C0G; C_0805_2012Metric; MPN GCM21B5C1H223JA16L
C348, C349, C368, C369: 100pF C0G; C_0603_1608Metric; MPN GCM1885C1H101JA16D
C350, C370: 15nF C0G; C_0805_2012Metric; MPN GCM2195C1H153JA16D
NT341, NT361: NetTie; NetTie-2_SMD_Pad0.5mm
PS341, PS361: MGJ2D121505SC; MGJ2_SIP7; MPN MGJ2D121505SC
R341, R342, R361, R362: 2.2; R_0603_1608Metric; MPN ERJ-3RQF2R2V
R343, R344, R363, R364: 49.9; R_0603_1608Metric; MPN ERJ-3EKF49R9V
U341, U361: AMC1302-Q1; SOIC-8W_TI_DWV_Slot; MPN AMC1302QDWVRQ1
U342, U362: TPS7B6950-Q1; SOT-23-5; MPN TPS7B6950QDBVRQ1

Connections of its further copies:
+3V3: C345.1, C346.1, C365.1, C366.1, U341.8 (VDD2), U361.8 (VDD2); also elsewhere on the board
+12V_PRI: PS341.1 (+Vin), PS361.1 (+Vin); also elsewhere on the board
/3_phase_sense/I2N_RAW: R344.1, U341.6 (OUTN); also elsewhere on the board
/3_phase_sense/I2P_RAW: R343.1, U341.7 (OUTP); also elsewhere on the board
/3_phase_sense/I3N_RAW: R364.1, U361.6 (OUTN); also elsewhere on the board
/3_phase_sense/I3P_RAW: R363.1, U361.7 (OUTP); also elsewhere on the board
/3_phase_sense/sense_2/GND1: C341.2, C342.2, C343.2, C344.2, C348.2, C349.2, NT341.2, PS341.6 (0Vout), U341.4 (GND1), U342.3 (GND), U342.4 (GND)
/3_phase_sense/sense_2/INN: C347.2, C349.1, R342.2, U341.3 (INN)
/3_phase_sense/sense_2/INP: C347.1, C348.1, R341.2, U341.2 (INP)
/3_phase_sense/sense_2/VDD1: C342.1, C343.1, C344.1, U341.1 (VDD1), U342.5 (OUT)
/3_phase_sense/sense_2/VISO: C341.1, PS341.7 (+Vout), U342.1 (IN)
/3_phase_sense/sense_3/GND1: C361.2, C362.2, C363.2, C364.2, C368.2, C369.2, NT361.2, PS361.6 (0Vout), U361.4 (GND1), U362.3 (GND), U362.4 (GND)
/3_phase_sense/sense_3/INN: C367.2, C369.1, R362.2, U361.3 (INN)
/3_phase_sense/sense_3/INP: C367.1, C368.1, R361.2, U361.2 (INP)
/3_phase_sense/sense_3/VDD1: C362.1, C363.1, C364.1, U361.1 (VDD1), U362.5 (OUT)
/3_phase_sense/sense_3/VISO: C361.1, PS361.7 (+Vout), U362.1 (IN)
/CTL_I2N: C350.2, R344.2; also elsewhere on the board
/CTL_I2P: C350.1, R343.2; also elsewhere on the board
/CTL_I3N: C370.2, R364.2; also elsewhere on the board
/CTL_I3P: C370.1, R363.2; also elsewhere on the board
/SNS2_SN: NT341.1, R342.1; also elsewhere on the board
/SNS2_SP: R341.1; also elsewhere on the board
/SNS3_SN: NT361.1, R362.1; also elsewhere on the board
/SNS3_SP: R361.1; also elsewhere on the board
GND: C345.2, C346.2, C365.2, C366.2, PS341.2 (0Vin), PS361.2 (0Vin), U341.5 (GND2), U361.5 (GND2); also elsewhere on the board

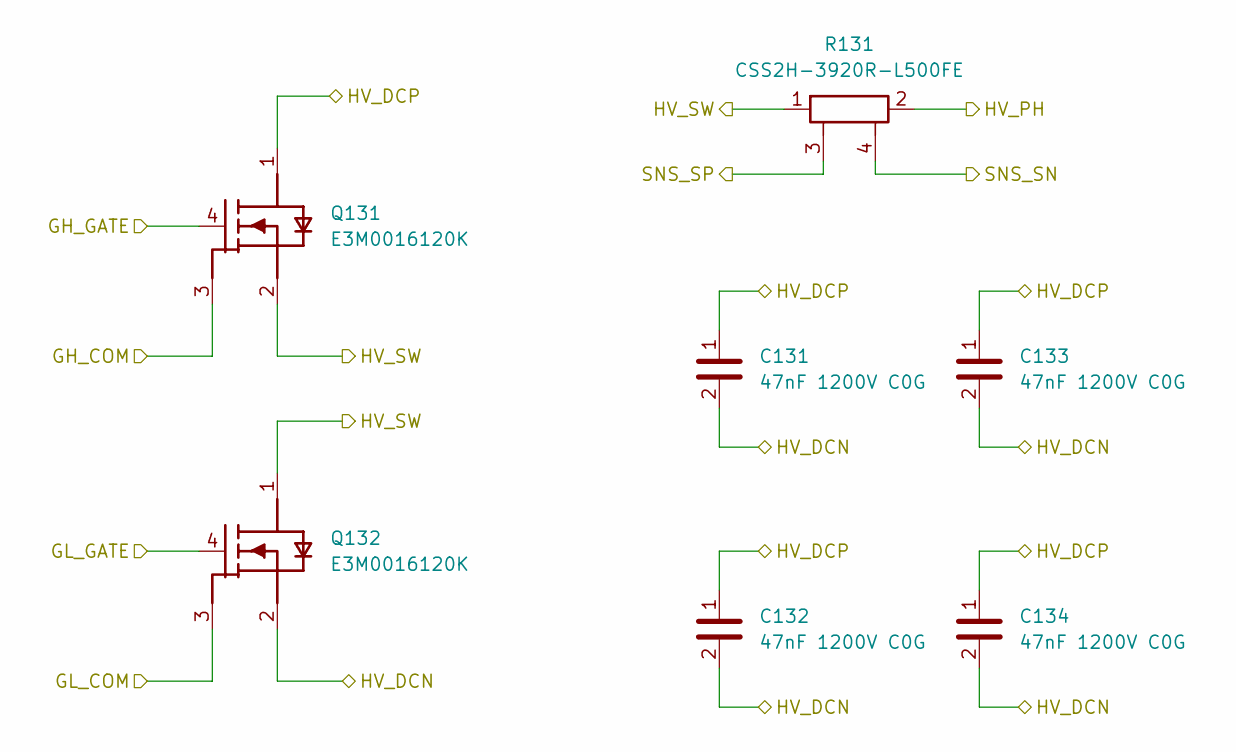
[picture p10: schematic leg.kicad_sch, Half-bridge leg (3 instances)]

Parts:
C131, C132, C133, C134: 47nF 1200V C0G; C_3640_9110Metric; MPN CKC33C473KEGACAUTO
Q131, Q132: E3M0016120K; TO-247-4L_Wolfspeed_Vertical; MPN E3M0016120K
R131: CSS2H-3920R-L500FE; R_Shunt_3920_Kelvin; MPN CSS2H-3920R-L500FE

Connections:
/1_power_stage/HV_PH3: R131.2; also elsewhere on the board
/GH3_COM: Q131.3 (S_K); also elsewhere on the board
/GH3_GATE: Q131.4 (G); also elsewhere on the board
/GL3_COM: Q132.3 (S_K); also elsewhere on the board
/GL3_GATE: Q132.4 (G); also elsewhere on the board
/HV_DCN: C131.2, C132.2, C133.2, C134.2, Q132.2 (S); also elsewhere on the board
/HV_DCP: C131.1, C132.1, C133.1, C134.1, Q131.1 (D); also elsewhere on the board
/HV_SW3: Q131.2 (S), Q132.1 (D), R131.1; also elsewhere on the board
/SNS3_SN: R131.4 (S2); also elsewhere on the board
/SNS3_SP: R131.3 (S1); also elsewhere on the board

Parts of its further copies:
C111, C112, C113, C114, C121, C122, C123, C124: 47nF 1200V C0G; C_3640_9110Metric; MPN CKC33C473KEGACAUTO
Q111, Q112, Q121, Q122: E3M0016120K; TO-247-4L_Wolfspeed_Vertical; MPN E3M0016120K
R111, R121: CSS2H-3920R-L500FE; R_Shunt_3920_Kelvin; MPN CSS2H-3920R-L500FE

Connections of its further copies:
/1_power_stage/HV_PH1: R111.2; also elsewhere on the board
/1_power_stage/HV_PH2: R121.2; also elsewhere on the board
/GH1_COM: Q111.3 (S_K); also elsewhere on the board
/GH1_GATE: Q111.4 (G); also elsewhere on the board
/GH2_COM: Q121.3 (S_K); also elsewhere on the board
/GH2_GATE: Q121.4 (G); also elsewhere on the board
/GL1_COM: Q112.3 (S_K); also elsewhere on the board
/GL1_GATE: Q112.4 (G); also elsewhere on the board
/GL2_COM: Q122.3 (S_K); also elsewhere on the board
/GL2_GATE: Q122.4 (G); also elsewhere on the board
/HV_DCN: C111.2, C112.2, C113.2, C114.2, C121.2, C122.2, C123.2, C124.2, Q112.2 (S), Q122.2 (S); also elsewhere on the board
/HV_DCP: C111.1, C112.1, C113.1, C114.1, C121.1, C122.1, C123.1, C124.1, Q111.1 (D), Q121.1 (D); also elsewhere on the board
/HV_SW1: Q111.2 (S), Q112.1 (D), R111.1; also elsewhere on the board
/HV_SW2: Q121.2 (S), Q122.1 (D), R121.1; also elsewhere on the board
/SNS1_SN: R111.4 (S2); also elsewhere on the board
/SNS1_SP: R111.3 (S1); also elsewhere on the board
/SNS2_SN: R121.4 (S2); also elsewhere on the board
/SNS2_SP: R121.3 (S1); also elsewhere on the board

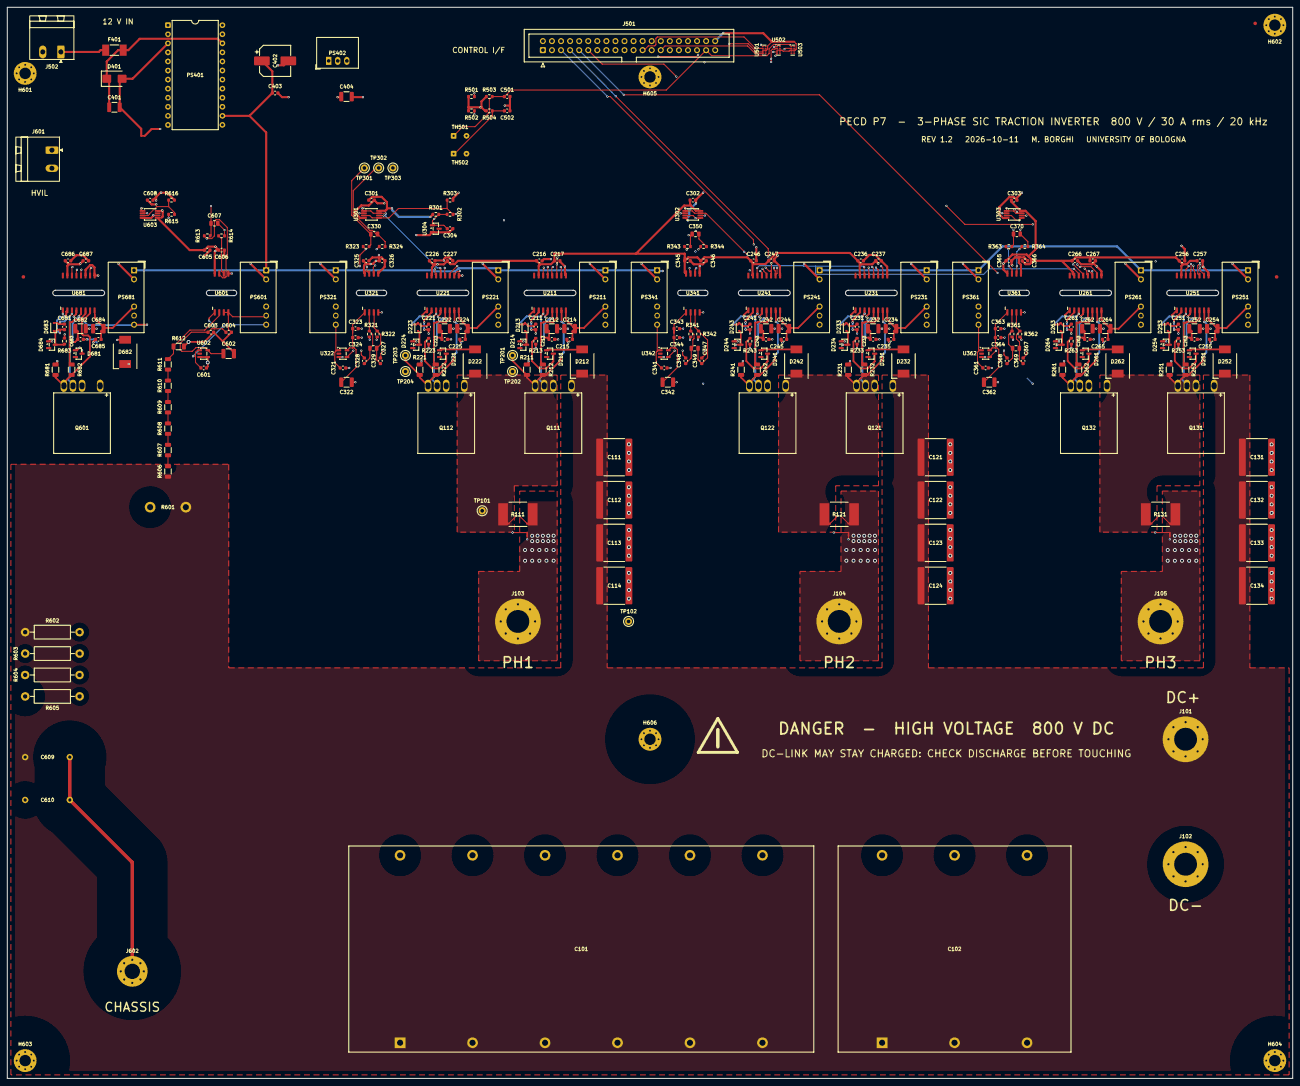
[picture p11: board PECD_P7.kicad_pcb from above]

Board: 6 copper layers, 360.0 x 300.0 mm, 278 parts (0 on the bottom side), 143 nets.

Other parts of the board:
FID1, FID2, FID3: Fiducial_1mm_Mask2mm
