matteoborghi/pecd-p7-kicad/(commit log)

2026-09-27 Initial KiCad project: rules, libraries, empty schematic
    [PECD_P7.kicad_pcb, PECD_P7.kicad_sch]
2026-10-01 Add missing footprints, fix AMC1311 pinout, add MPN fields
    - MGJ2_SIP7 (from KiCad stdlib, checked against Murata datasheet) and
    R_Shunt_3920_Kelvin (Bourns pad layout, net tie between power and
    sense pads) were referenced by symbols but missing.
    - AMC1311 pin 2 is IN and pin 3 is SHTDN (TI SBAS897C); the symbol
    derived from AMC1302 called them INP/INN.
    - Every symbol now carries Manufacturer and MPN; new symbols for
    E3M0040120K, TEN 8-1212 and TPS7B6950-Q1; MKP1848 6/12-pin footprints.
    Verified with verifica_librerie.py (pins vs pads, MPN present, kicad-cli load).
2026-10-01 Rewrite design rules per isolation domain; rule areas in footprints
    Rev. 4 used one net class for all seven gate domains and demanded 4.5 mm
    between any two differently named nets in it, so GH1_GATE and GH1_COM
    (0.70 mm apart on the TO-247) would have flooded the DRC with false
    violations; the package exception also caught the Kelvin pin next to the
    source. Rev. 5 has one class per isolated domain, explicit rules toward
    each domain's own HV reference, HV_AUX/HV_DIV classes, a ZONA_MGJ2 area
    and a safety rule for unclassified nets.
    ZONA_PACKAGE, ZONA_ISOLATORE, ZONA_MGJ2 and KEEPOUT_BARRIERA now live in
    the footprints, so they cannot be forgotten. New HV footprints: D_SMC_HV
    (4.6 mm gap), Wi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
2026-10-03 Fix design rules: no-net pads, parse-safe net test, 0.15 mm LV floor
    Unconnected pads (NC pins, unused converter outputs) inherited the 2.0 mm
    HV class clearance from their neighbours and flagged their own package;
    they now get 0.15 mm. `A.Net != 0` made KiCad drop the whole file silently,
    replaced by `A.NetName != ''`. Verified with the 17-case rule harness and a
    full 269-footprint board with copper zones: 0 DRC violations.
2026-10-08 Complete schematic: ten sheets, roles, ordered references
    Hierarchical schematic of the inverter (power stage, seven gate-drive
    channels, three phase-current channels, aux supply, control interface,
    DC-link management), verified pin by pin against the design model:
    269 components, 0 connection differences; ERC leaves only the intended
    GND1-on-HV_DCN warning of the bus-voltage AMC1311 (U601).
    Every symbol carries a Ruolo field (used by the PCB placement script) and
    references follow sheet/instance blocks (e.g. Q121 = high side, leg B).
    Net classes CTRL and PWR_LV set to 0.15 mm, the VSSOP-8 pad gap.
    [1_power_stage.kicad_sch, 2_gate_drive.kicad_sch, 3_phase_sense.kicad_sch, 4_aux_supply.kicad_sch, 5_control_if.kicad_sch, 6_dclink_mgmt.kicad_sch, PECD_P7.kicad_sch, drv_channel.kicad_sch]
2026-10-08 Treat unconnected-(...) nets as no-net pads in design rules
    After Update PCB from Schematic every free pin gets its own net,
    "unconnected-(U342-NC-Pad2)", instead of an empty name. The no-net rule
    did not match them, so they fell under the 9.5 mm unclassified-net rule
    and the real board showed hundreds of false clearance violations.
    Verified on a copy of the real board: 0 DRC errors after the fix.
2026-10-09 Add PCB: 269 footprints placed, centered on A2, planes and power vias
    Board 360 x 300 mm, 6 layers, outline starting at (117, 60) so it sits
    inside the A2 drawing-sheet frame. Placement from schema/piazzamento.py
    (gate loop ~20 mm), 38 barrier/power footprints locked, ten copper zones
    filled, 48 power vias on the HV_DCN plane, board minimum clearance 0.15 mm.
    No tracks yet. DRC: 0 errors, 0 schematic differences, 499 connections
    still to route.
    [PECD_P7.kicad_pcb]
2026-10-09 Fix pre-routing issues: connector direction, MGJ2 GND escapes, M3 holes
    - Rotate J502 and J601 so the screw-terminal mouth faces the board edge.
    - Pre-route the GND pin of the 11 MGJ2 converters (single diagonal + via to
    the GND planes): the pin sits 7.62 mm from the floating pin 5, so any
    other exit violates the reinforced-isolation rules.
    - Add six M3 mounting holes H601-H606 (no net) plus a design rule keeping
    HV and floating-domain copper 9.5 mm away from them (the screw is at
    chassis potential through the enclosure).
    DRC: 0 errors, 0 schematic differences, 535 connections left to route.
    [6_dclink_mgmt.kicad_sch, PECD_P7.kicad_pcb]
2026-10-10 Exempt signal-level HV connections from the bus width warning
    The minimum width warnings for HV_BUS (10.4 mm) and HV_POWER (8.4 mm)
    target the load-current paths. Two connections on those nets carry only
    milliamps: the DESAT diode cathode to the drain (D2?2) and the DC-link
    voltage measurement around U601 (rule area MISURA_BUS on the PCB).
    They are now excluded; every other narrow HV track still warns.
    Rule regression tests (prova_regole/verifica_regole.py) still pass.
2026-10-10 Complete PCB routing and clean up DRC warnings
    - All connections routed (0 unconnected), only 0/45/90 degree tracks.
    - Gate loops of all seven channels within 25 mm (23.7/24.3 mm), sense
    pairs side by side on In3, COM islands on B.Cu for floating domains.
    - Silkscreen references placed readably (0/90 deg, 1 mm, off pads).
    - Warnings fixed: GND of U501-U503 at full 0.6 mm width, C302 tied to
    the 0.6 mm +3V3 track, dangling stubs trimmed, two vias moved to keep
    0.5 mm between holes, D212 back at its design position.
    - Rule area MISURA_BUS around the DC-link measurement group.
    DRC: 0 violations of any severity, 0 schematic differences.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
    [PECD_P7.kicad_pcb]
2026-10-10 Make silkscreen readable and label the board
    Re-place reference designators so each one sits closer to its own part
    than to any neighbour; add board name, revision, HV warning with the
    ISO 7010 triangle, and labels for the power terminals and connectors.
    No copper changes.
    [PECD_P7.kicad_pcb]
2026-10-10 Add 3D models for the project footprints
    Stock KiCad models where the package exists (SOIC-16W, SOIC-8 7.5x5.85,
    SMC, 2512 scaled to the 3920 shunt); simple VRML bodies with datasheet
    dimensions for TO-247-4L, MGJ2, MKP1848 and the Y1 disc. The MGJ2
    footprint pointed to a model KiCad 10 does not ship.
    [PECD_P7.kicad_pcb]
2026-10-10 Fill title blocks and add fabrication notes
    Every schematic sheet and the PCB now carry title, date, revision 1.0,
    institution and author. The PCB gets the fabrication notes on
    User.Drawings (laminate CTI >= 600, conformal coating with UV tracer,
    2 kV L1-L2 withstand, isolator slots): process requirements the DRC
    cannot check. No electrical changes.
    [1_power_stage.kicad_sch, 2_gate_drive.kicad_sch, 3_phase_sense.kicad_sch, 4_aux_supply.kicad_sch, 5_control_if.kicad_sch, 6_dclink_mgmt.kicad_sch, PECD_P7.kicad_pcb, PECD_P7.kicad_sch]
2026-10-10 Translate descriptive part values to English
    Terminals, test points, fixing holes and the chassis lug had Italian
    values ("M6 fase 1", "TP rosso"...) that showed in the report figures.
    Same change in the PCB footprints and in the reference model, so the
    schematic-to-model comparison and the parity check stay clean.
    [1_power_stage.kicad_sch, 2_gate_drive.kicad_sch, 3_phase_sense.kicad_sch, 6_dclink_mgmt.kicad_sch, PECD_P7.kicad_pcb]
2026-10-11 Revision 1.1: second-layer phase copper, inner-layer clearance, rail fit
    Add an HV_PHk pour on B.Cu with 20 stitching vias under each shunt, where
    the phase pour on F.Cu narrowed to 8 mm. Relax the HV_DCN clearance on
    inner layers to 2.25 mm (IPC-2221B internal conductors): the smaller
    clearance holes in the plane take the commutation loop from about 12 to
    7.8 nH. Move TP101 out from under the cold rail and the gate test points
    1.5 mm away from it; draw the rail, pad and clips on User.Drawings.
    [1_power_stage.kicad_sch, 2_gate_drive.kicad_sch, 3_phase_sense.kicad_sch, 4_aux_supply.kicad_sch, 5_control_if.kicad_sch, 6_dclink_mgmt.kicad_sch, PECD_P7.kicad_pcb, PECD_P7.kicad_sch]
2026-10-11 Fix wrong order codes found while pricing the BOM
    R503/R504 (2.2 k) carried the order code of a 10 k resistor and R303
    (10 k) that of a 2.15 k: hand-typed fields the role script never
    overwrote. Seven MGJ2 had the manufacturer as "Murata" instead of
    "Murata Power Solutions". Schematic, PCB fields and reference model now
    agree (new check: schema/verifica_mpn.py). No circuit change.
    [3_phase_sense.kicad_sch, 5_control_if.kicad_sch, PECD_P7.kicad_pcb, drv_channel.kicad_sch]
2026-10-11 Revision 1.2: fiducials, serial-number box, coating keep-out drawing
    [1_power_stage.kicad_sch, 2_gate_drive.kicad_sch, 3_phase_sense.kicad_sch, 4_aux_supply.kicad_sch, 5_control_if.kicad_sch, 6_dclink_mgmt.kicad_sch, PECD_P7.kicad_pcb, PECD_P7.kicad_sch]
2026-10-11 Root sheet: A3 page with the system requirements R1-R14
    Text only; no connectivity change (ERC: known U601 warning only, parity 0).
    [PECD_P7.kicad_sch]
2026-10-15 Power stage module outline on User.1 (30 parts of sheets 1_power_stage and leg)
    Drawing only: no track, zone or footprint changes. DRC 0 violations,
    0 unconnected, schematic parity 0.
    [PECD_P7.kicad_pcb]
2026-11-05 Prepare the repository for publication
    Remove the .history gitlink (a nested KiCad repository tracked without a
    .gitmodules entry), ignore local backups and fabrication outputs, and add a
    README that describes the sheets, libraries and tags.
